byogaratchagan/BMS-with-Battery-reconfiguration-Circuit/presentations/bms_posters/p2.jpeg

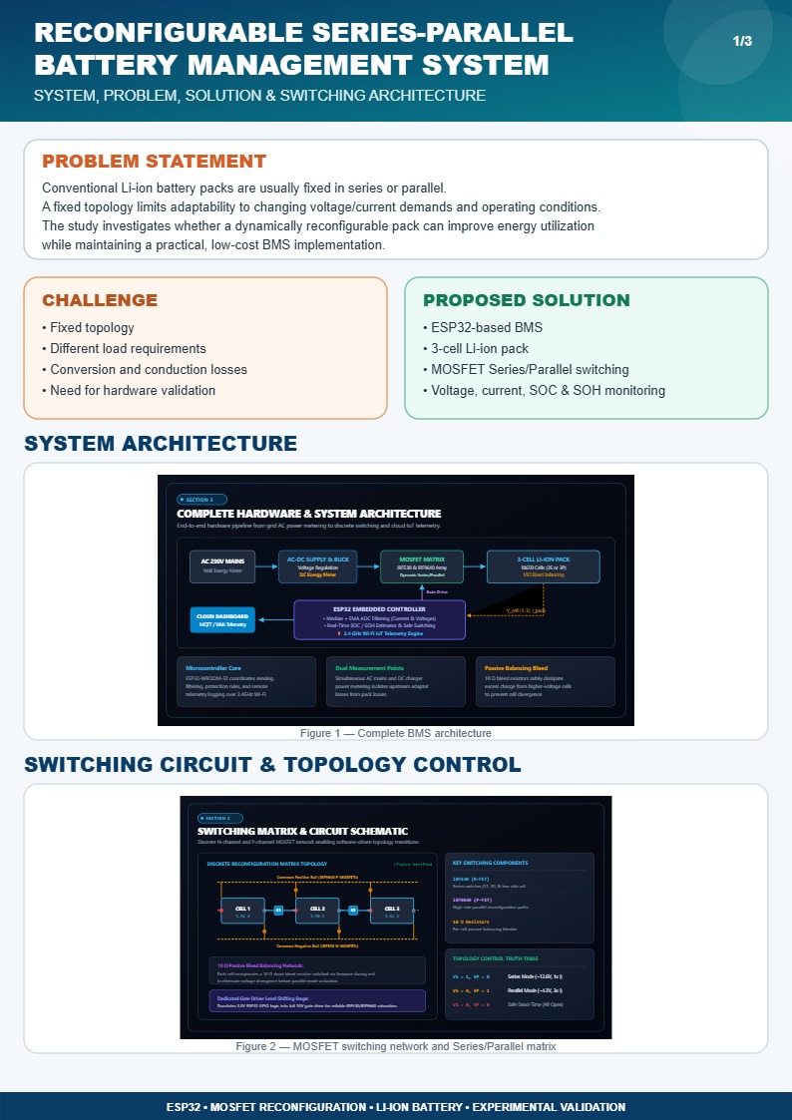
presentations/bms_posters/p2.jpeg
