byogaratchagan/BMS-with-Battery-reconfiguration-Circuit/presentations/bms_posters/posters.docx

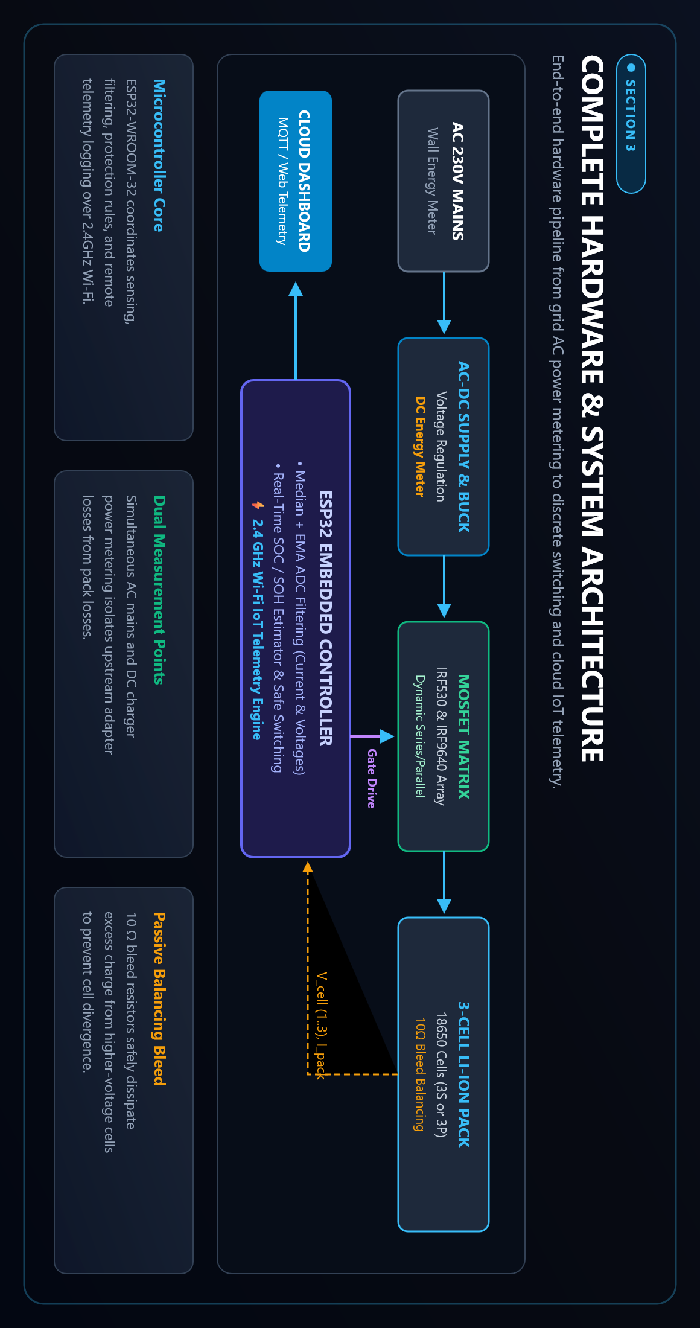
[picture p20: figure]
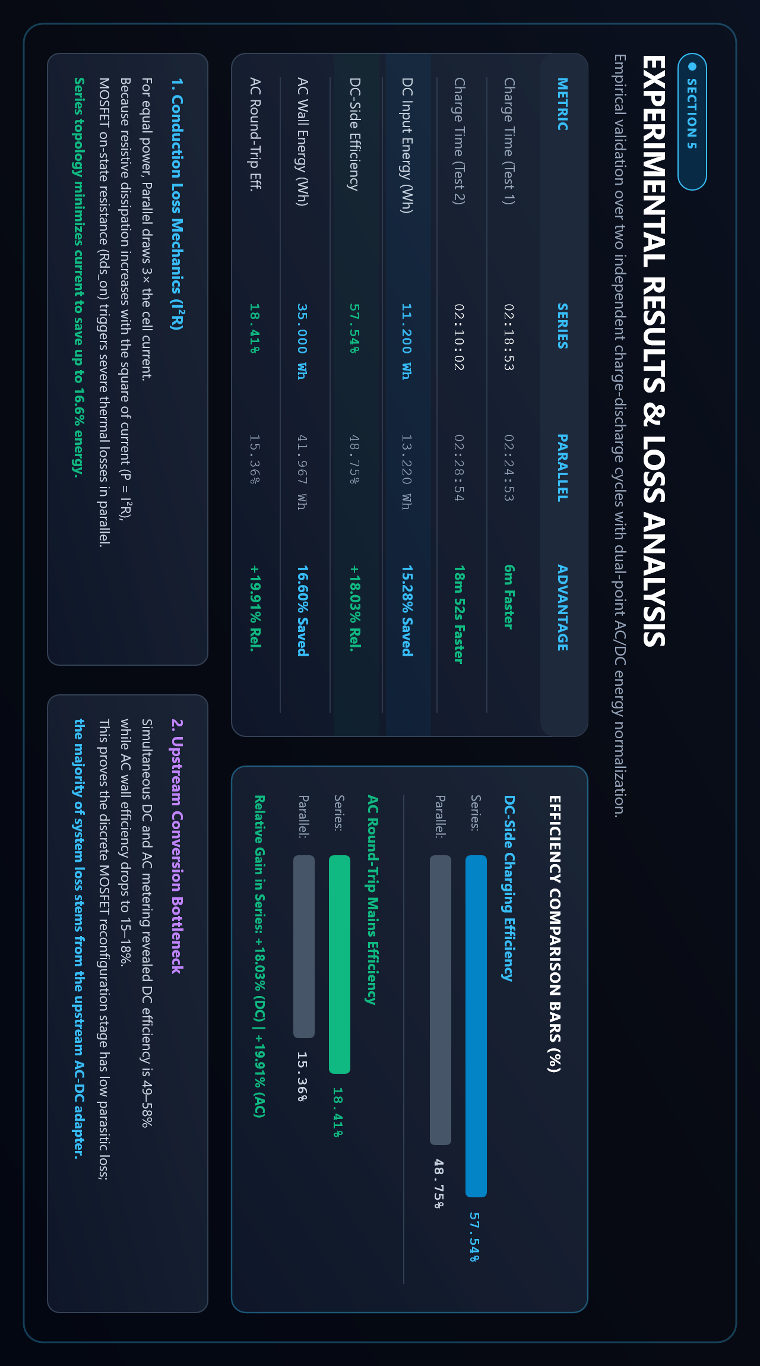
[picture p21: figure]
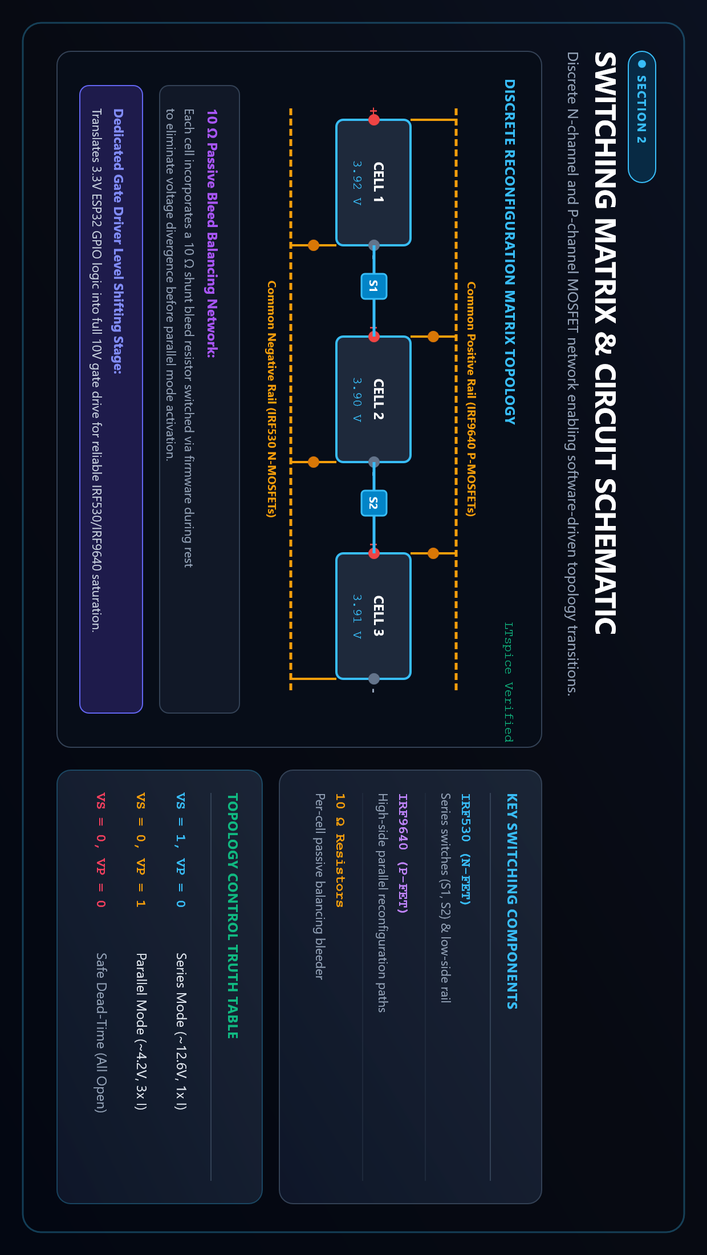
[picture p22: figure]
