byogaratchagan/BMS-with-Battery-reconfiguration-Circuit/code/dashboard(V1)/plots/bms_charging_curve.png

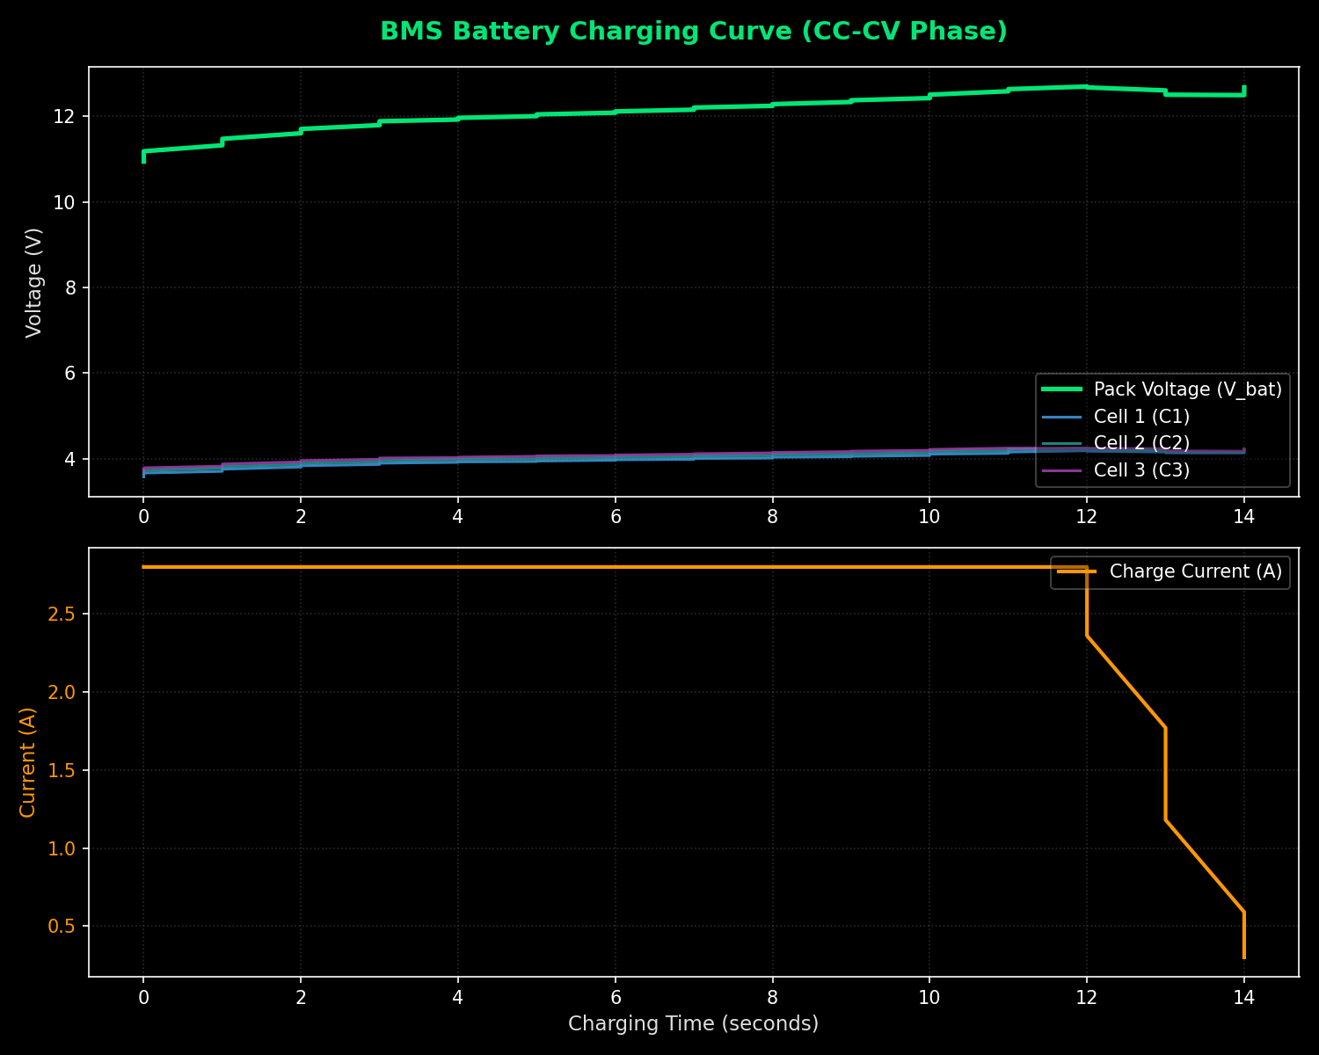
code/dashboard(V1)/plots/bms_charging_curve.png
