byogaratchagan/BMS-with-Battery-reconfiguration-Circuit/code/dashboard(V1)/plots/bms_overall_telemetry.png

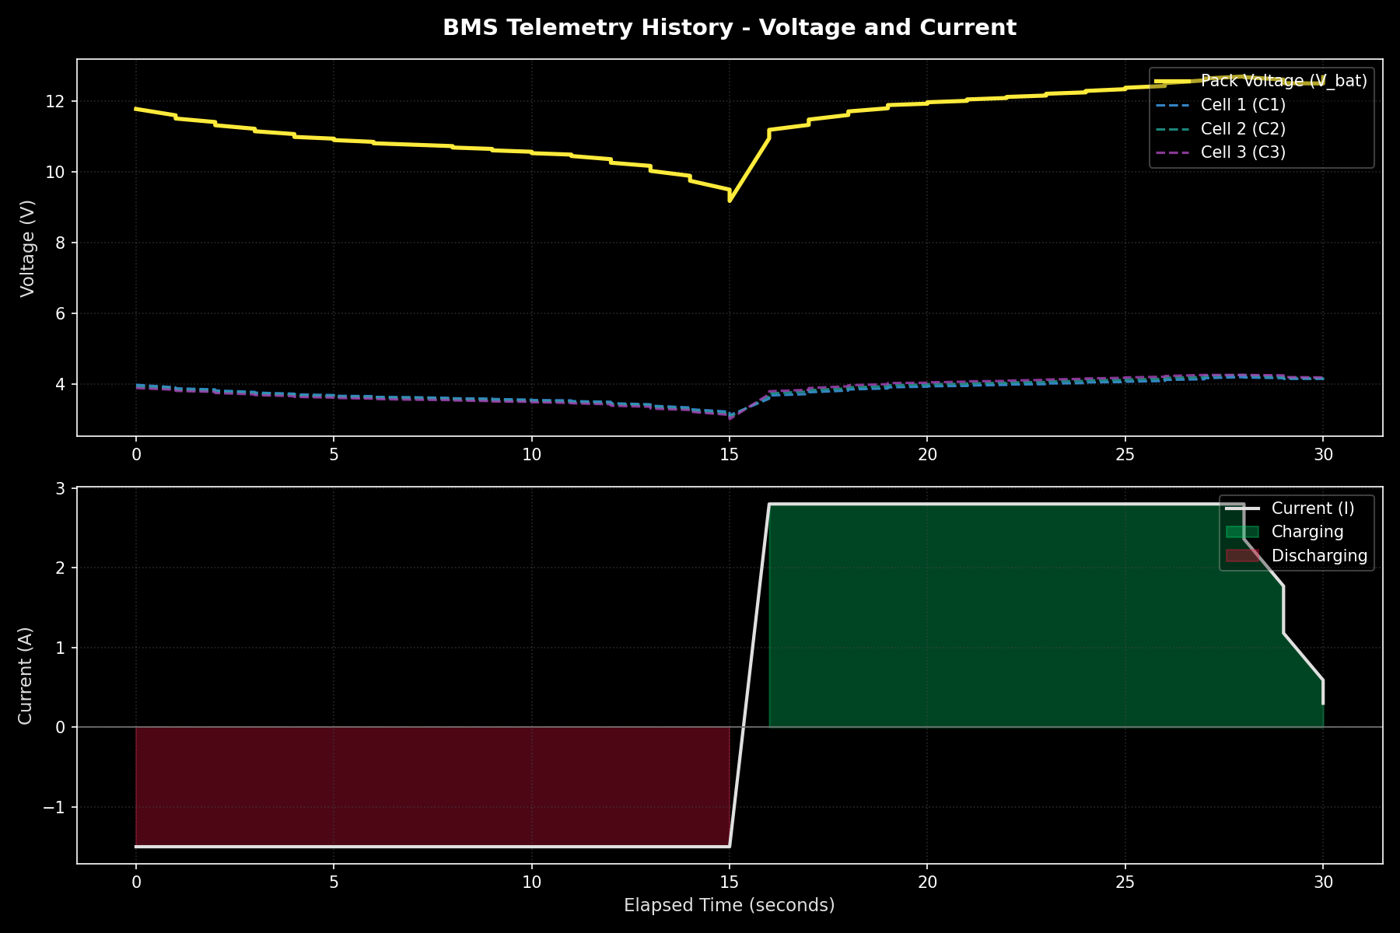
code/dashboard(V1)/plots/bms_overall_telemetry.png
