byogaratchagan/BMS-with-Battery-reconfiguration-Circuit/presentations/bms_posters/p1.jpeg

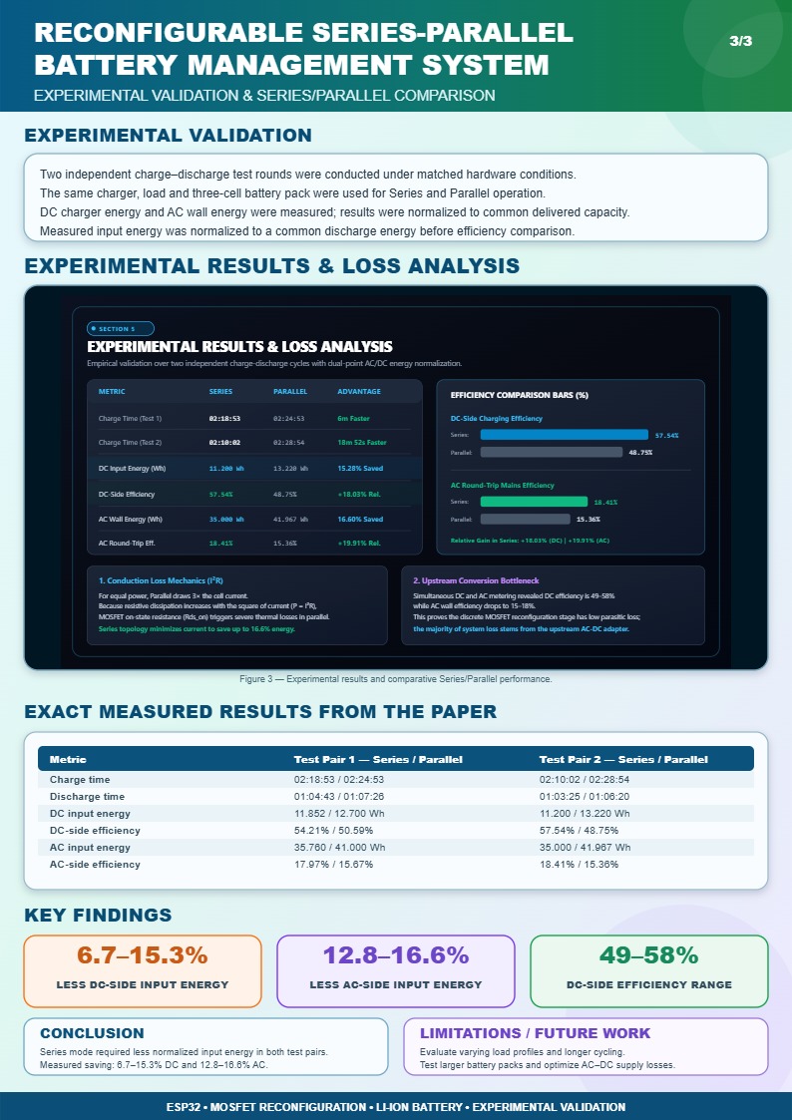
presentations/bms_posters/p1.jpeg
