byogaratchagan/BMS-with-Battery-reconfiguration-Circuit/presentations/bms_posters/p3.jpeg

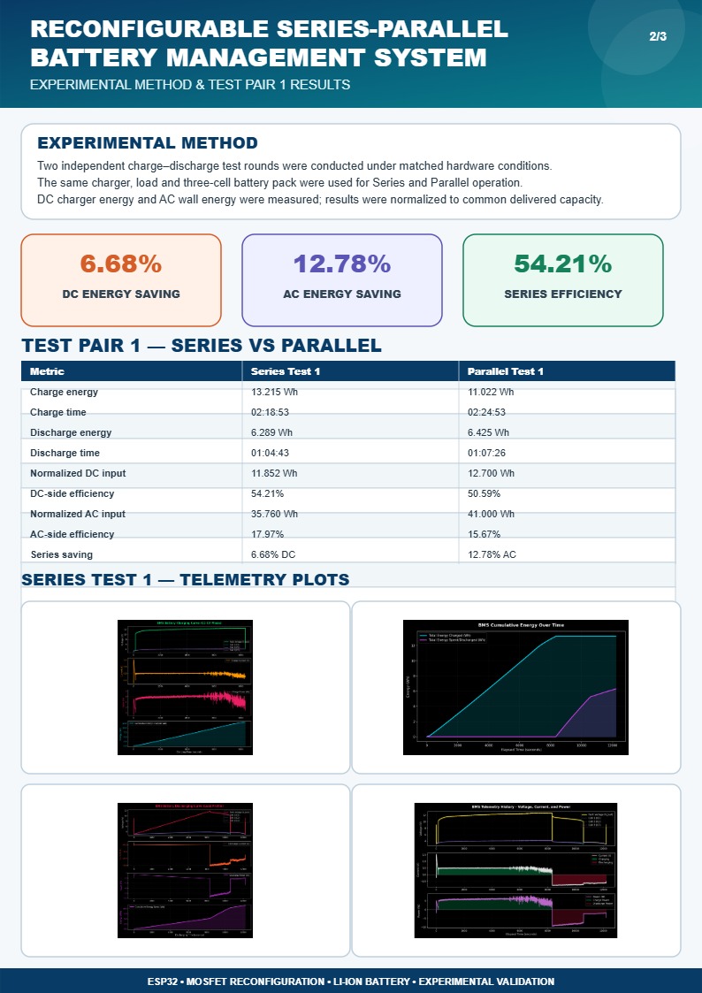
presentations/bms_posters/p3.jpeg
