byogaratchagan/BMS-with-Battery-reconfiguration-Circuit/presentations/bms_prototype.jpeg

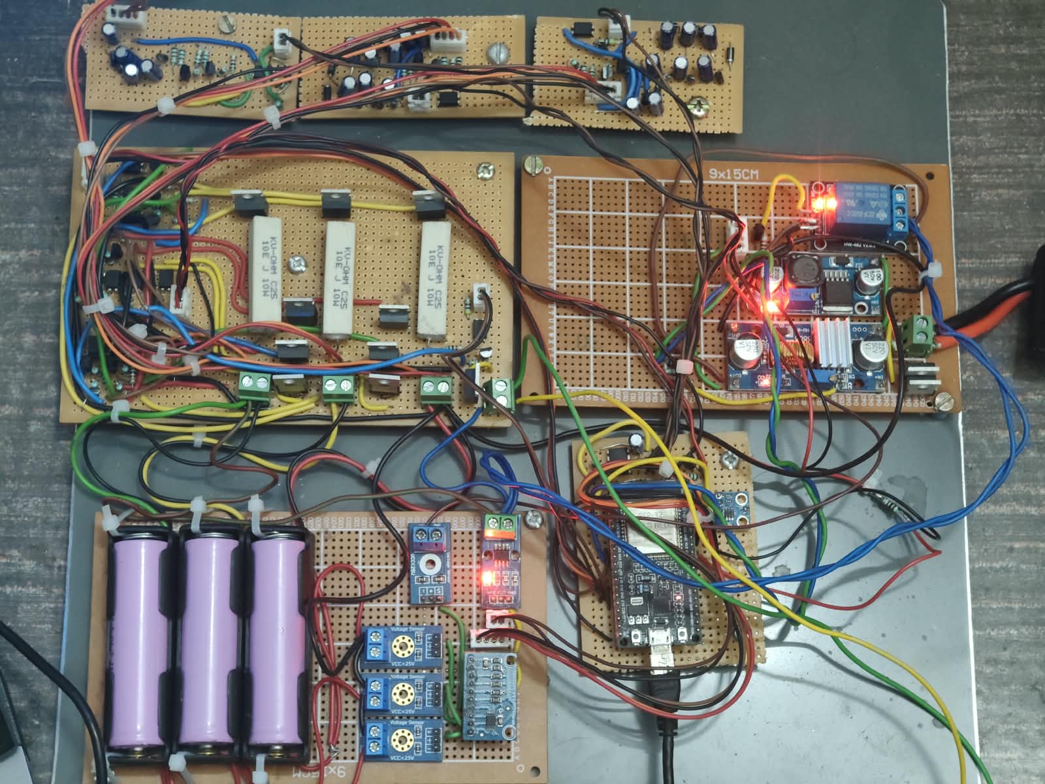
presentations/bms_prototype.jpeg
