byogaratchagan/BMS-with-Battery-reconfiguration-Circuit/presentations/bms_prototype_2.jpeg

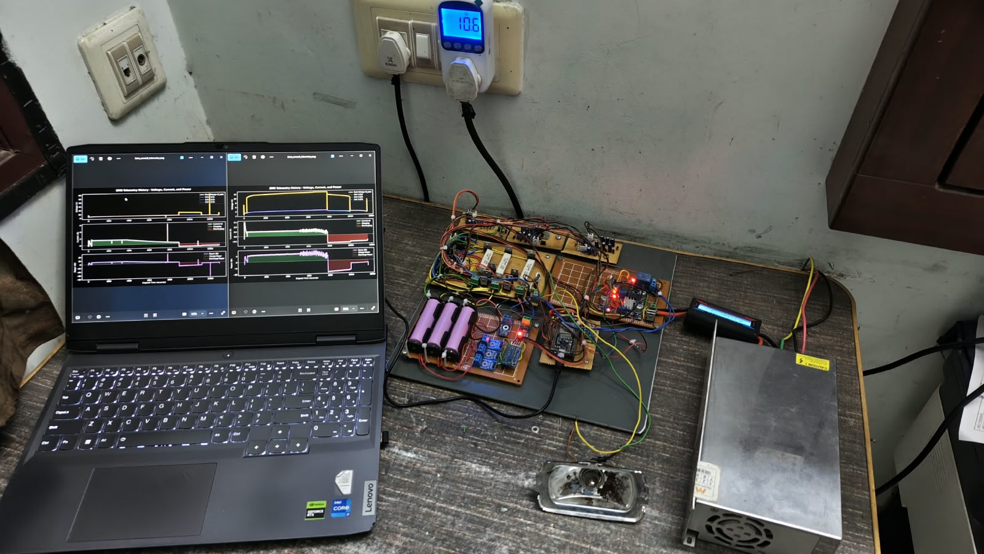
presentations/bms_prototype_2.jpeg
