byogaratchagan/BMS-with-Battery-reconfiguration-Circuit/simulation_and_testing/test_pair1/Parallel/parallel_dc_test1.jpeg

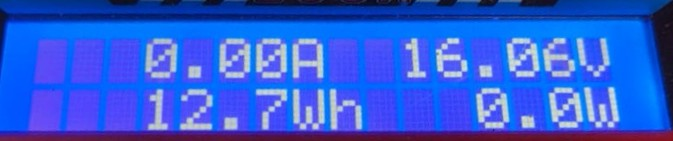
simulation_and_testing/test_pair1/Parallel/parallel_dc_test1.jpeg
