byogaratchagan/BMS-with-Battery-reconfiguration-Circuit/simulation_and_testing/test_pair1/Parallel/parallel_test1_plots/bms_discharging_curve.png

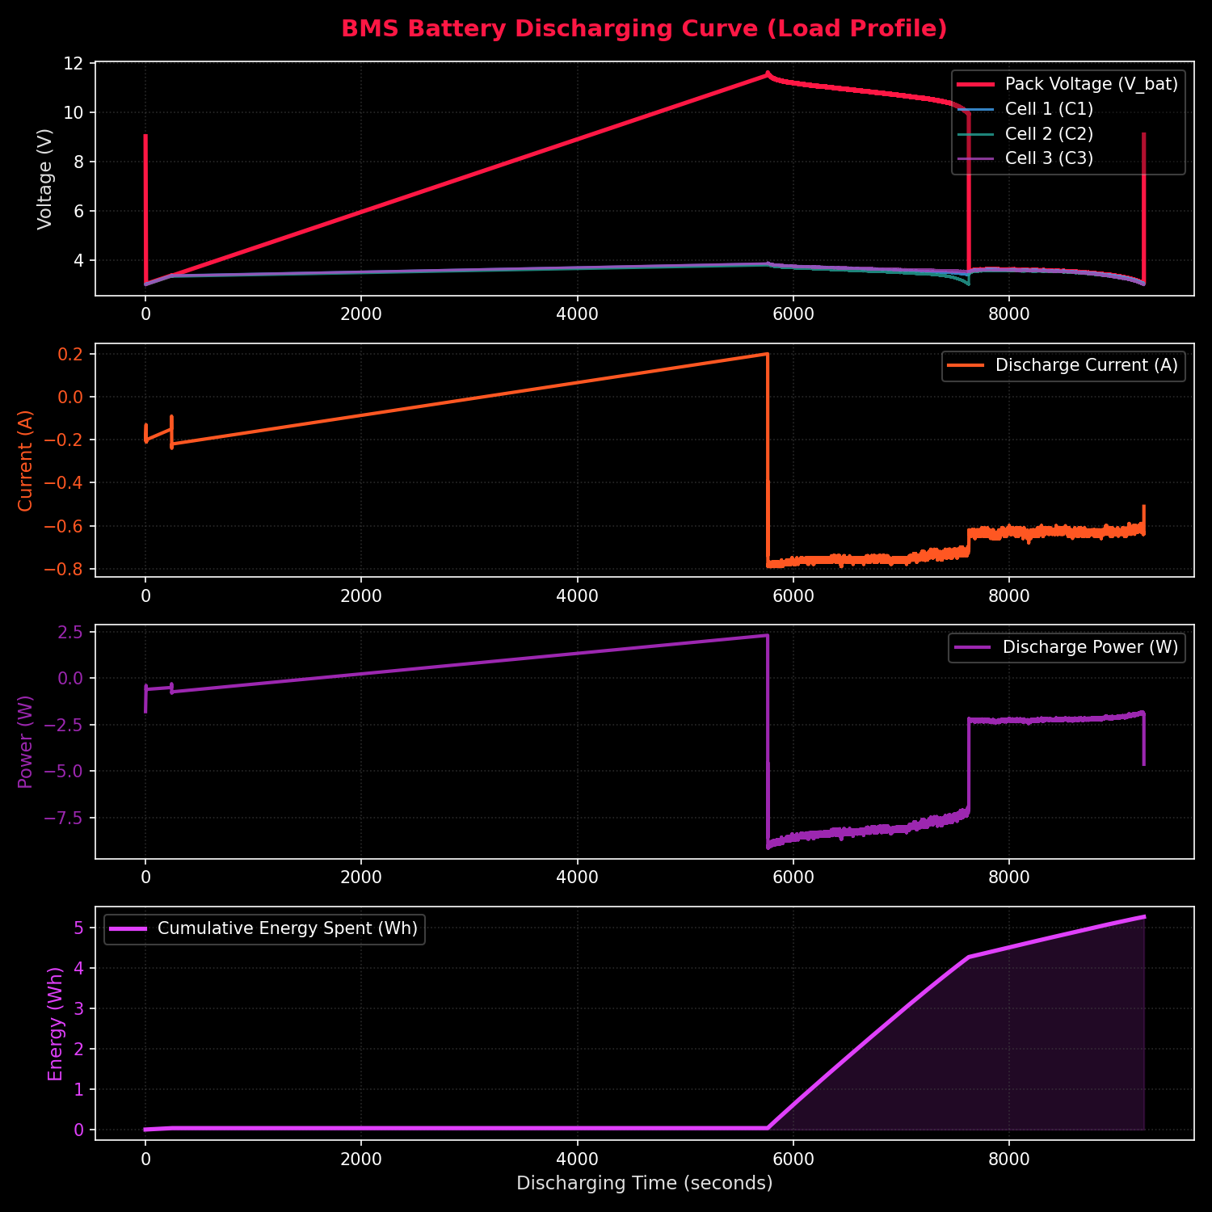
simulation_and_testing/test_pair1/Parallel/parallel_test1_plots/bms_discharging_curve.png
