byogaratchagan/BMS-with-Battery-reconfiguration-Circuit/simulation_and_testing/test_pair1/Series/series_ac_test1.jpeg

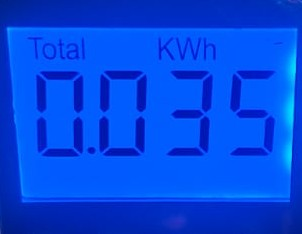
simulation_and_testing/test_pair1/Series/series_ac_test1.jpeg
