byogaratchagan/BMS-with-Battery-reconfiguration-Circuit/simulation_and_testing/test_pair1/Series/series_test1_plots/bms_charging_curve.png

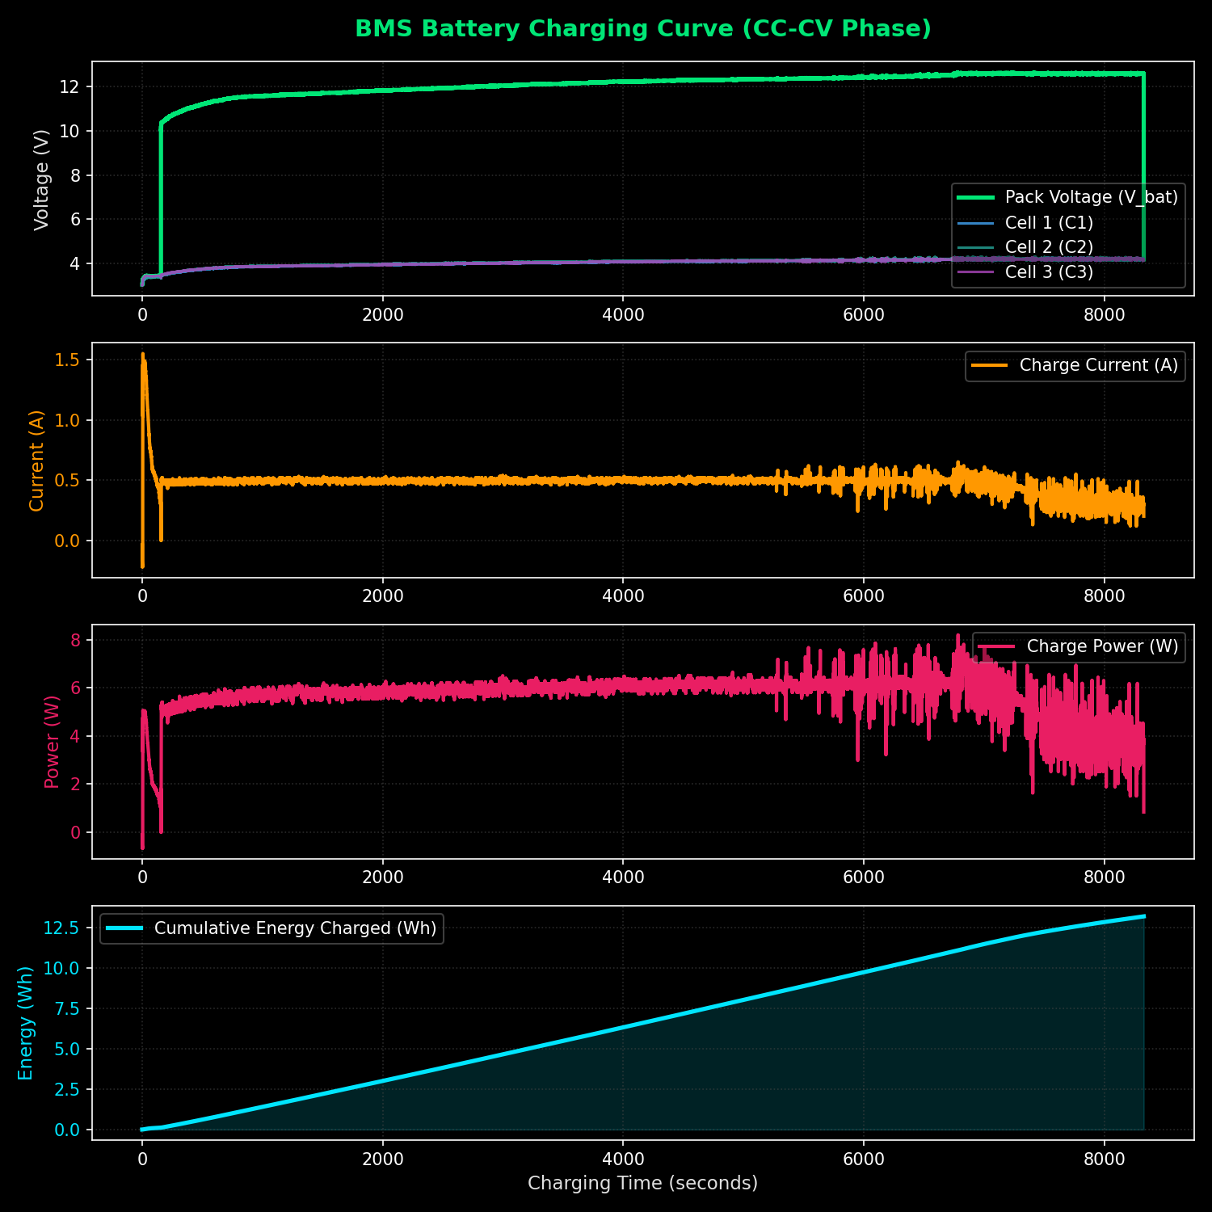
simulation_and_testing/test_pair1/Series/series_test1_plots/bms_charging_curve.png
