byogaratchagan/BMS-with-Battery-reconfiguration-Circuit/circuits_spice/MOSFET_driver_circuit.asc

C1: cap; 10µF
C2: cap; 0.1µf
C3: cap; 10µF
C4: cap; 10µF
C5: cap; 10µF
C6: cap; 100µF
C7: cap; 2000pF
D3: diode; 1N5819
D6: diode; 1N5819
D7: diode; 1N5819
D8: diode; 1N5819
Q1: npn; BC547B
Q2: npn; BC547B
Q7: npn; BC547B
R1: res; 1k
R2: res; 50
R3: res; 480
R4: res; 100
R5: res; 480
R6: res; 800
R7: res; 100
R8: res; 50
R11: res; 1k
R12: res; 50
R13: res; 1k
R14: res; 10k
R15: res; 100k
R16: res; 100
S1: sw; MYSW
U1: NE555
U2: PC817A
U4: PC817A
V1: voltage; PULSE(0 1 0.8 1u 1u 10 20)
V2: voltage; 5
V4: voltage; 3; Rser=0.1
V5: voltage; 5
Named nets: 0, 5v, B-, M1+, OS_OUT, B+
.tran 10 uic
.model MYSW SW(Ron=0.01 Roff=10G Vt=0.5)
