byogaratchagan/BMS-with-Battery-reconfiguration-Circuit/circuits_spice/Switch_circuit.asc

Bleed_R1: res; 10
Bleed_R2: res; 10
Bleed_R3: res; 10
Cell1: voltage; 4.2
Cell2: voltage; 4.2
Cell3: voltage; 4.2
M1: nmos; IRF530
M2: nmos; IRF530
M3: pmos; IRF9640
M4: nmos; IRF530
M5: nmos; IRF530
M6: nmos; IRF530
M7: nmos; IRF530
M8: nmos; IRF530
M9: pmos; IRF9640
V2: voltage; 10
V4: voltage; 10
V5: voltage; {VS}
V7: voltage; 10
V8: voltage; {VS}
V9: voltage; {VP}
V10: voltage; {VP}
V11: voltage; {VP}
V12: voltage; {VP}
Named nets: 0
.tran 5
.param VS=0 VP=10
#Set VS=10 VP=0 in .param to make series
#Set VS=0 VP=10 in .param to make series
